FreelanceJavaDev/ArduinoDataGloveHV/README.md

# ArduinoDataGloveHV
Arduino Data Glove using custom Capactior and High Voltage Power Source
This was an Honors Capstone project that included a practical build, demo and paper.  This is the code.
Physical Design:

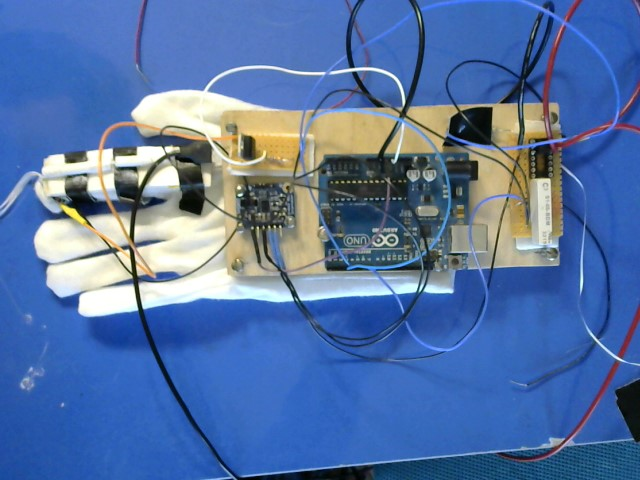
[picture p1: Additional_Information/Haptic_Glove_physical.jpg]


Circuit Diagram:

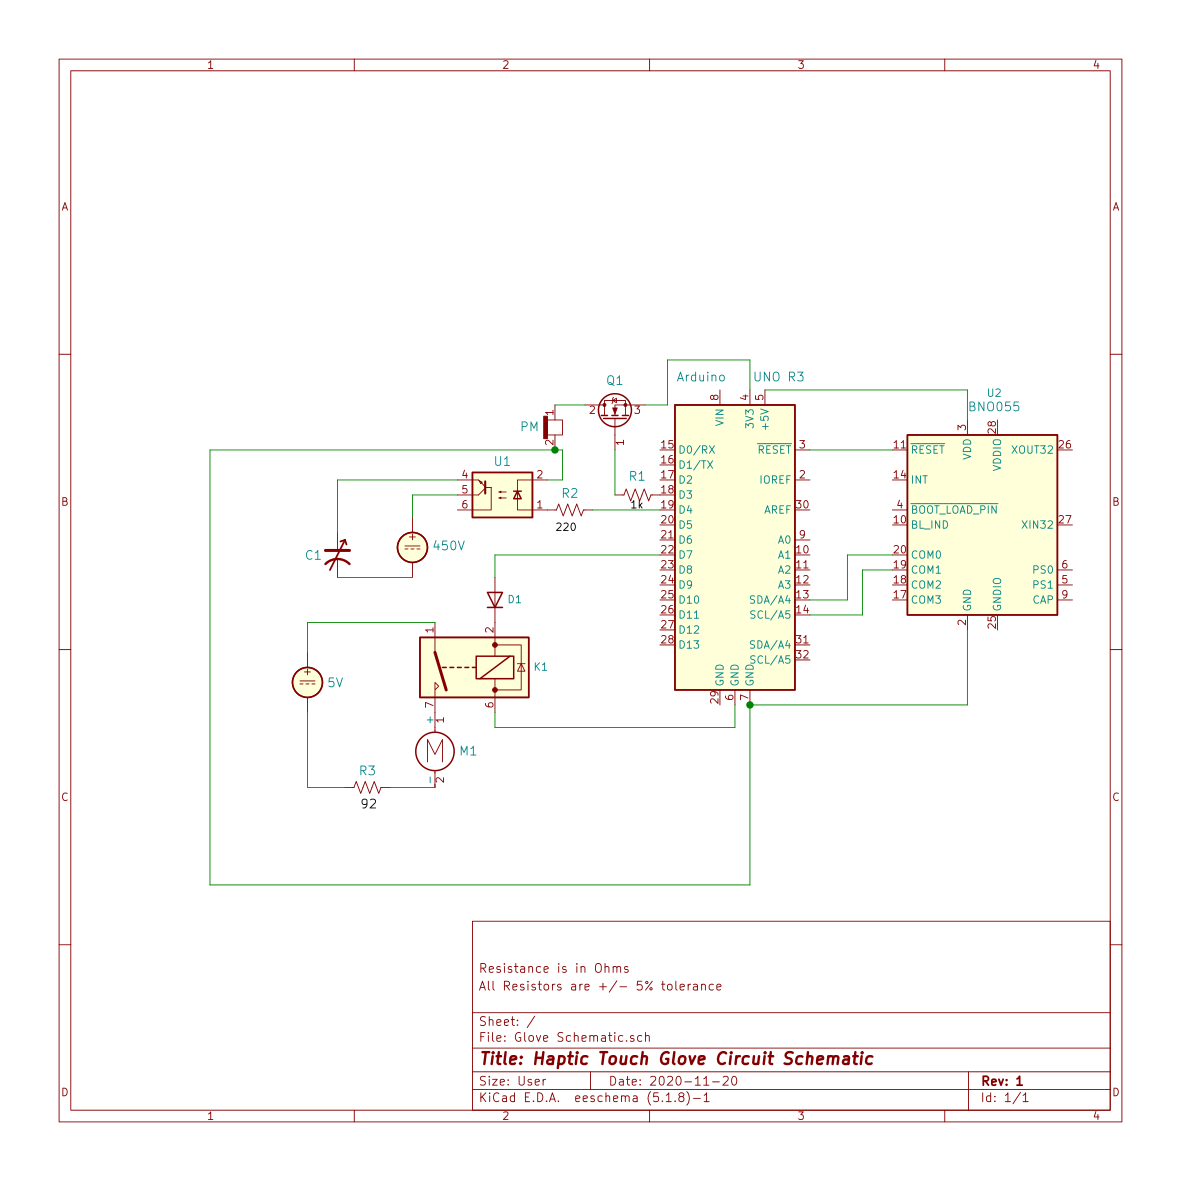
[picture p2: Additional_Information/Glove_Schematic.png]
Circuit Diagram
