FreelanceJavaDev/ArduinoDataGloveHV/Haptic Touch Glove/Assets/table.obj

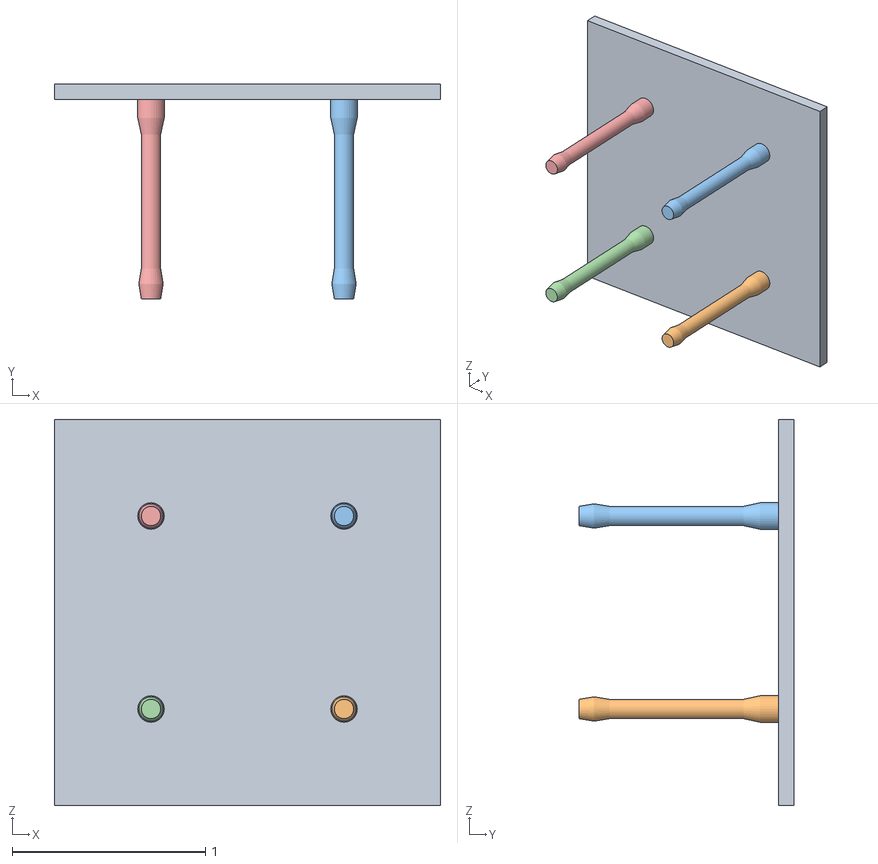
[picture p16: CAD file, 2020-11-29]
Haptic Touch Glove/Assets/table.obj
2.00 x 1.11 x 2.00
